chrnas/KartRobot/TSEA29 - Projektdokument/Användarhandledning/Figurer/20231201_112949.jpg

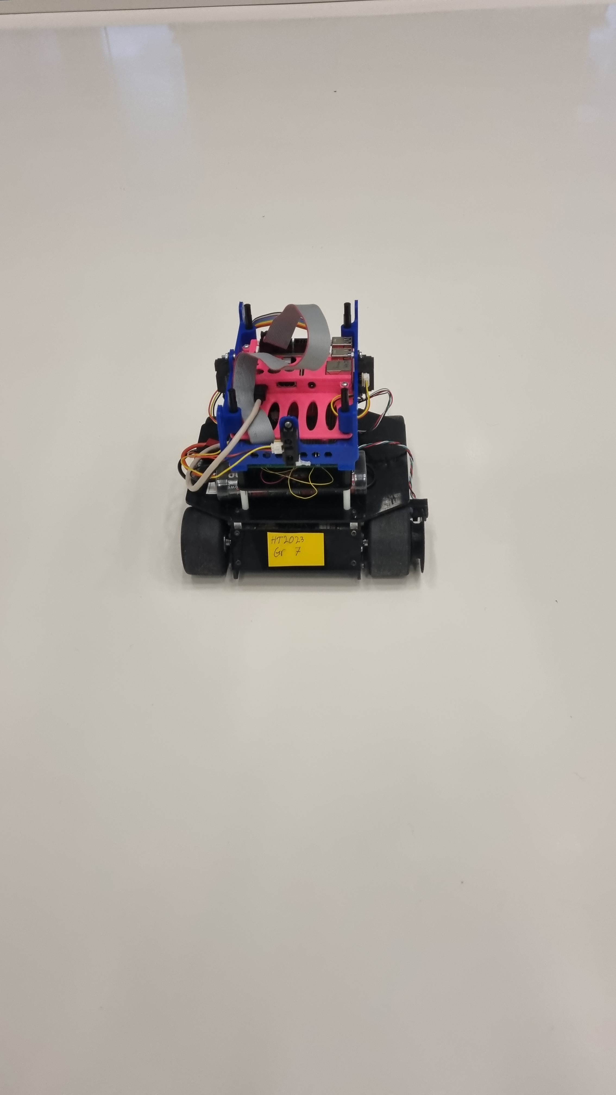
TSEA29 - Projektdokument/Användarhandledning/Figurer/20231201_112949.jpg
