chrnas/KartRobot/README.md

# TSEA29 KMM Kod

Detta är ett repo för kod i kursen TSEA29 (KMM).

## Medlemmar

* Felix Ramnelöv ([felra653@student.liu.se](mailto:felra653@student.liu.se))
* Filip Nygren  ([filny841@student.liu.se](mailto:filny841@student.liu.se))
* Jacob Volz  ([jacvo343@student.liu.se](mailto:jacvo343@student.liu.se))
* Hannes Lindström  ([hanli001@student.liu.se](mailto:hanli001@student.liu.se))
* Christoffer Näs  ([chrna581@student.liu.se](mailto:chrna581@student.liu.se))
* Mikael Lundgren  ([miklu523@student.liu.se](mailto:miklu523@student.liu.se))

## Handledare

* Theodor Lindberg  ([theodor.lindberg@liu.se](mailto:theodor.lindberg@liu.se))

## Workflow

Vi använder oss av ett feature branch workflow, där man gör en ny branch för varje feature enligt namnkonventionen `feature-*namn*` och gör sedan en merge till master. Rimligtvis är en aktivitet från tidplanen en feature.

## Kod

Stil för kod följer standard enligt språk man använder sig av. Kod ska vara välkommenterad och väldokumenterad.

## Produkt
