chrnas/KartRobot/TSEA29 - Projektdokument/Presentation/Presentation.pptx

## Kartrobot

TSEA29 - G07

Notes: Felix

## Agenda

- Översiktlig beskrivning
- Redovisning av det tekniska resultatet
- Hur vi arbetar och löst praktiska problem
- Varför oss?
- Frågor

Notes: Felix

## Översiktlig besrkivning

## Översikt

- Autonom robot som kartlägger en bana
  - Styralgoritm
- Moduluppbyggd
  - Specificerat gränssnitt
- Självständig
  - Kartläggning görs i roboten
- Användargränssnitt för uppritning & hantering
  - Trådlös kommunikation

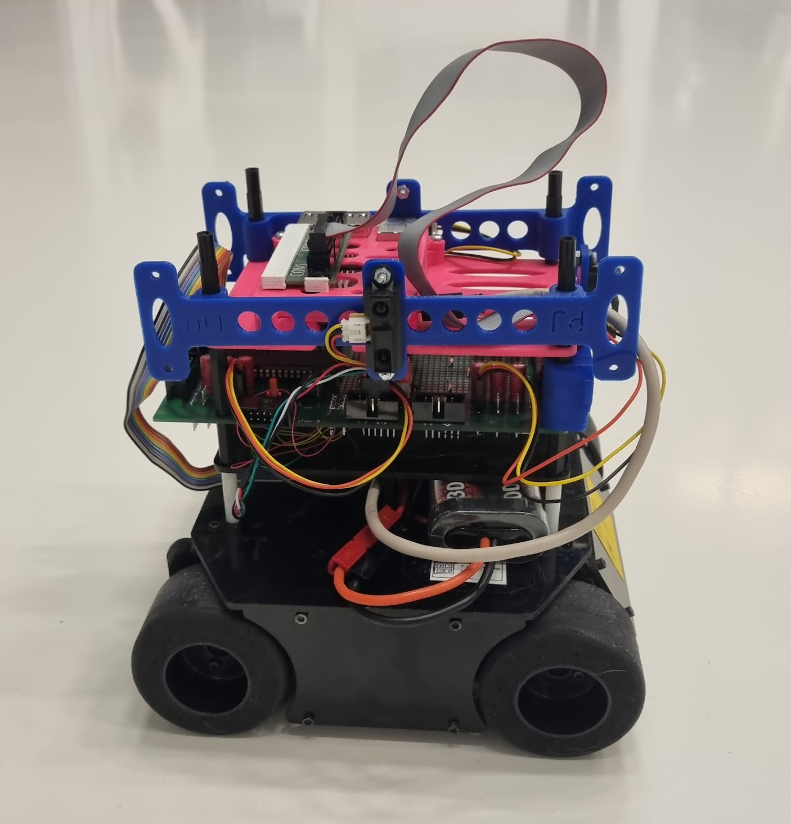
[picture p16: figure]

Notes: Jacob

## Redovisning av det tekniska resultatet

## Gränssnitt

- Inter-Integrated Circuit (I²C)
  - 1 buss
  - RPi master, 2 st AVR slavar
  - En byte skickas åt gången (Write & Read)
  - Python-bibliotek SMbus
- Bluetooth
  - Mellan RPi och extern dator
  - BT inbyggt på RPi
  - Python-bibliotek Socket

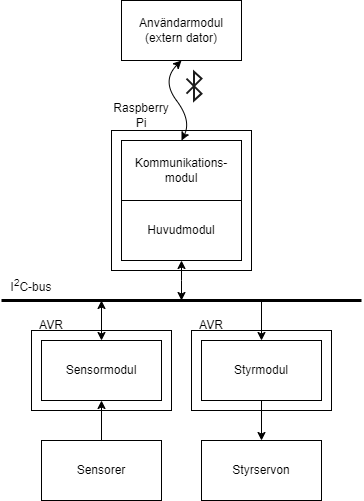
[picture p17: figure]

Notes: Hannes

## Sensormodul

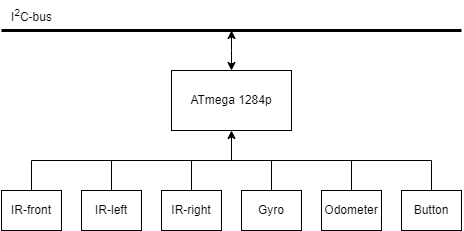
[picture p18: figure]

- Byggd på en AVR (ATmega 1284p)
- Flera sensorer
  - 3 st IR-avståndsmätare, 1 st odometer, 1 st gyroskop & 1 st dubbel tryckknapp
- Huvudloop med avbrott
- Analog & digital data
  - AD-omvandling
  - Avbrott
- TWI (I²C)
  - Slav (receiver & transmitter)
  - Write - välja data; Read - läsa vald data

Notes: Felix

## Styrmodul

- Kontrollerar robotens motorer
- Byggd på en AVR (Atmega1284p)
- 8-bitars insignalsvektor
- Huvudloop med avbrott
- TWI (I²C)
- 16-bitars Timer, Fast PWM (Pulse Width Modulation) Mode
  - PWM, Bra för strömreglering.

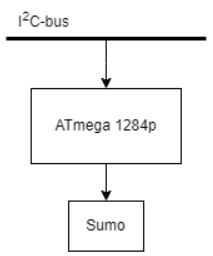
[picture p19: figure]
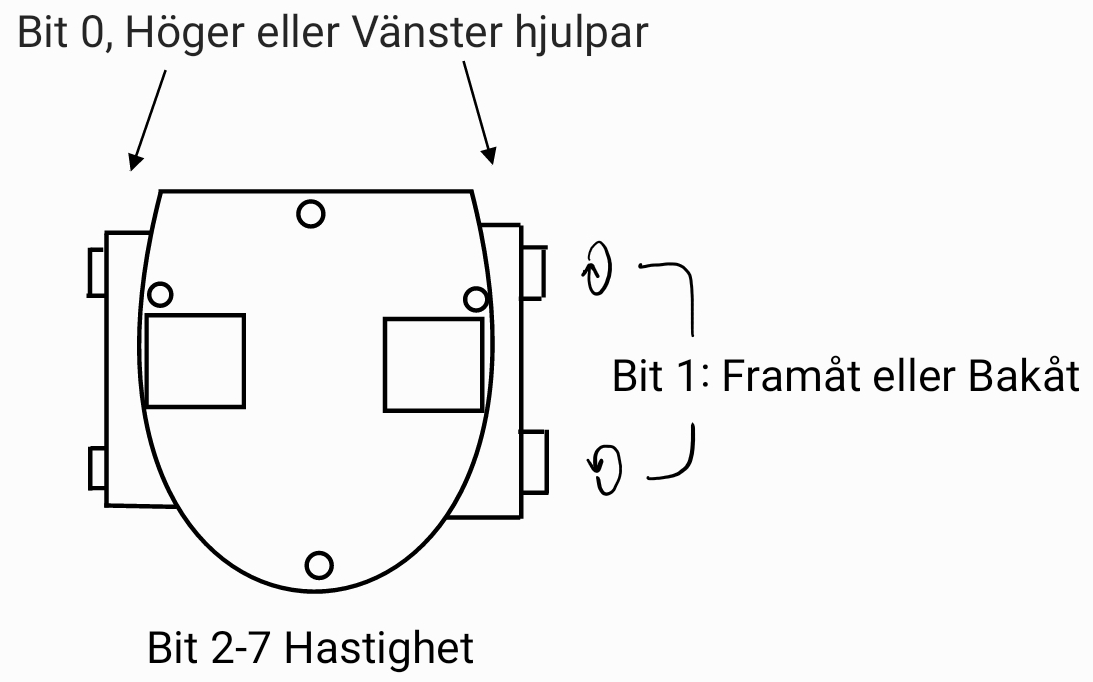
[picture p20: figure]

Kopplad till Sumo

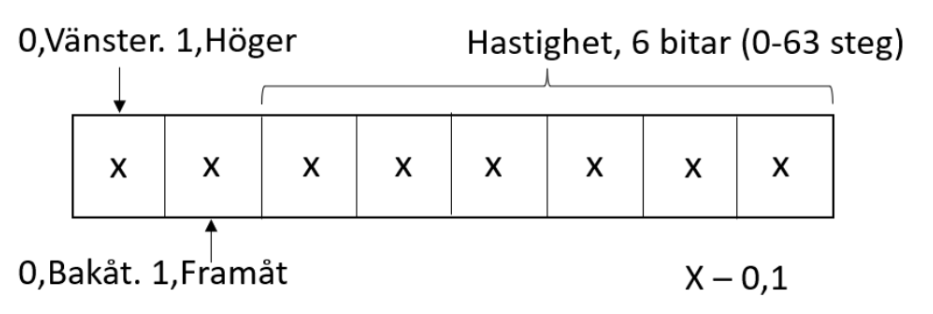
[picture p21: figure]

8-Bitars insignals vektor

Notes: Christoffer

## Kommunikationsmdodul

- Byggd på RPi (Raspberry Pi 3 Model B)
- Kommunikation med Bluetooth
  - Använder Python-biblioteket socket
  - Servern för Bluetooth byggd på RPi
- Skickar data från sensormodul och sökalgoritmen

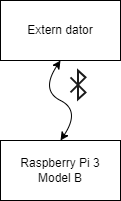
[picture p22: figure]

Notes: Jacob

## Användarmodul

- Skrivet i Python
  - På extern dator
  - PySide6
  - Python bibliotek för QT omgjort Från C++
  - Liten mängd QSS
- Funktioner
  - Uppritning av karta
  - Terminal för inkommande data
  - Knappar
  - Inforutor
  - Manuell styrning

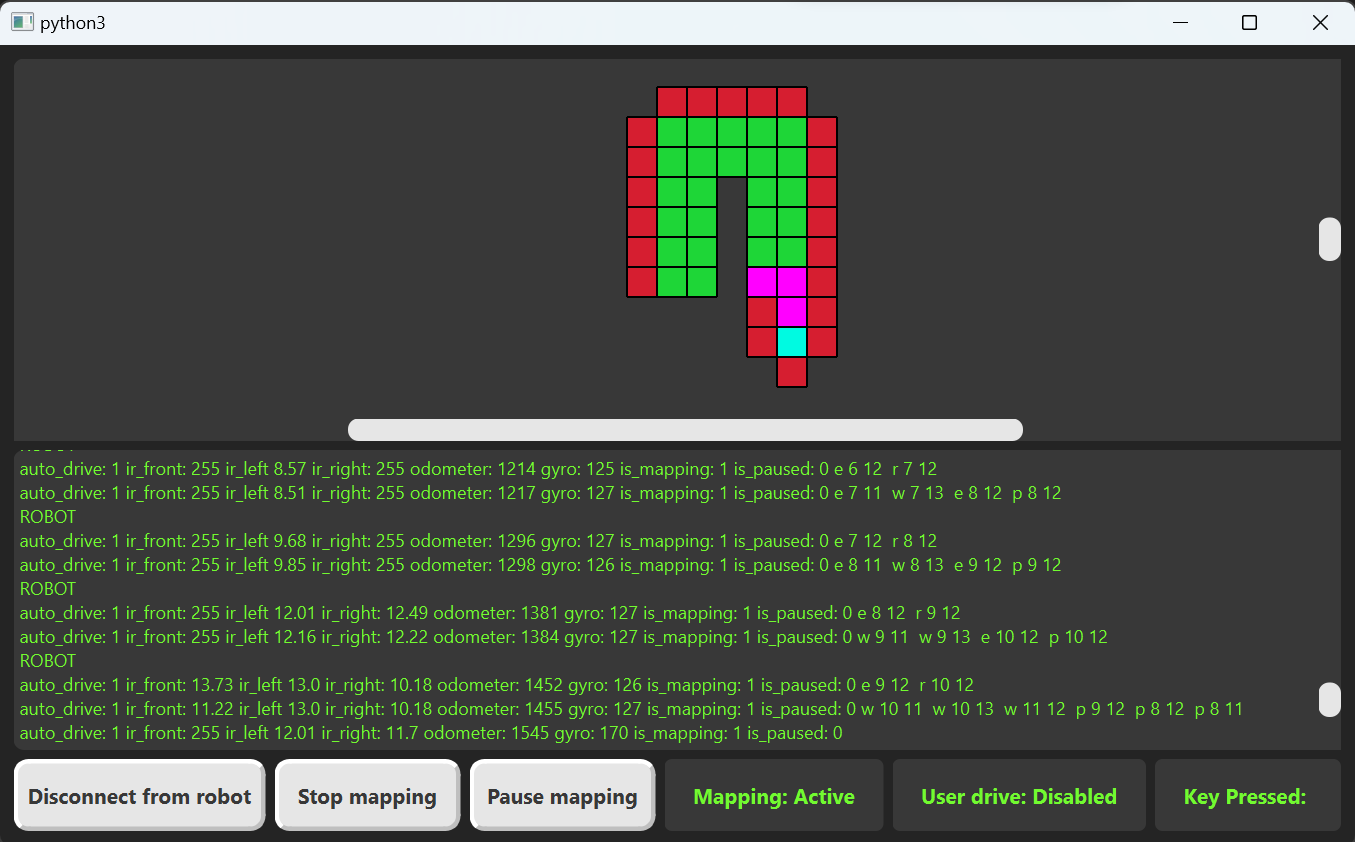
[picture p23: figure]

Notes: Hannes

## Huvudmodul

- Byggd på samma RPi som kommunikationsmodul
- “Spindeln i nätet”
  - Master på I²C-bussen
  - Ber om data från sensormodul
  - Kör SLAM-algoritm i Python
  - Skriver styrkommandon till styrmodul
  - Färdigställer och tillhandahåller data till kommunikationsmodul
  - Väljer autonomt/manuellt körläge
  - Väljer om bluetooth extern dator ska användas

Notes: Filip

## Hur vi arbetat och löst praktiska problem

## Arbetsätt

- V-model
- XP-principer
  - Parprogrammering
  - Testdriven utveckling (TDD)
- Modul-branches
  - En bransch per modul för parallellt arbete.

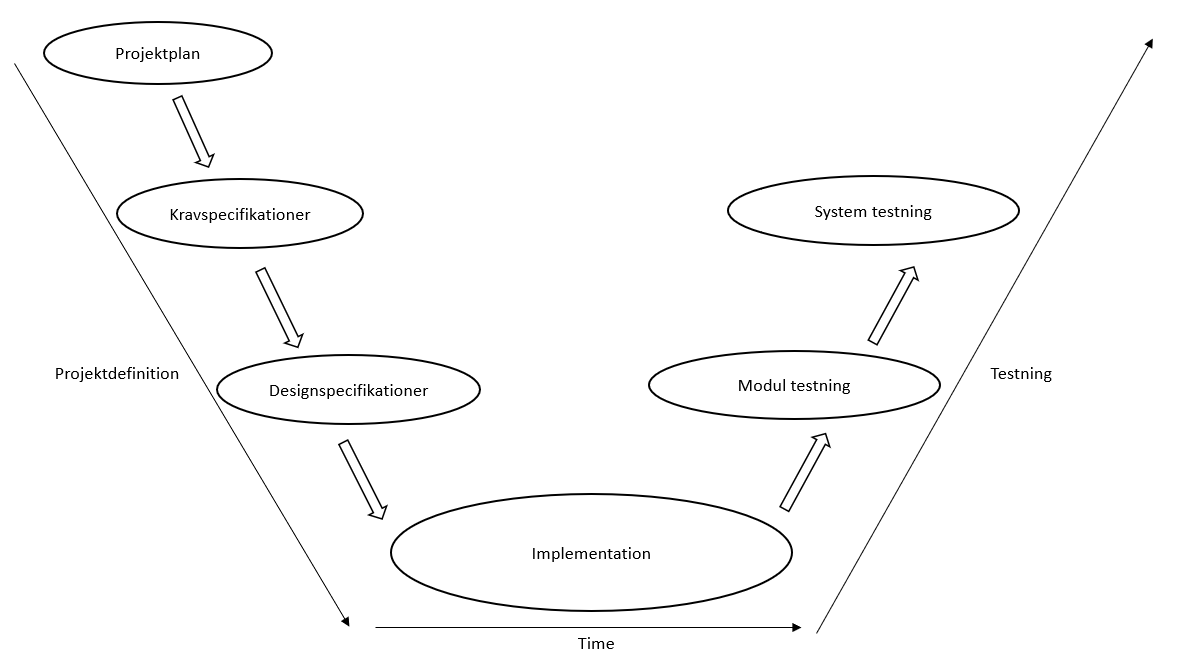
[picture p24: figure]

Projekt utformat efter V-model

Notes: Christoffer

## Praktiska problem

## Sökning

- Kartan
  - 2-dimensional array
  - 4 st sorters rutor
  - Okända, besökta, obesökta och väggar
- “Left-first” - DFS
  - Prioriterar obesökta rutor till vänster om roboten
  - Lägger på rutor till höger om och framför roboten först på avsöknings-stacken
- Smart avsökning
  - Säkerställer att en ruta borde besökas
  - Rutor som är omringade av kända rutor kastas ur avsöknings-stacken

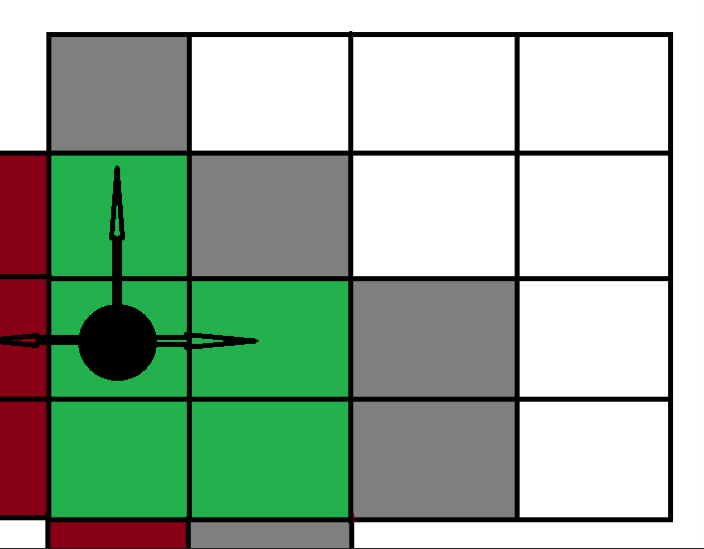
[picture p25: figure]

Notes: Mikael

## Pathfinding

- Hitta bästa väg till känd ruta
- Breadth first search (BFS)
  - Likt DFS med kö istället för stack
  - Roboten behöver inte röra sig när algoritmen utförs
  - Enkelt att implementera
- A* search algorithm
  - Manhattan Distance
  - Väg med färre svängar mer effektiv & mindre felmarginal
  - Prioritetskö med heuristik för väg med minst antal svängar
- Genomför båda och jämför
  - A* använder en heuristik vilket kan leda till fel i vissa fall

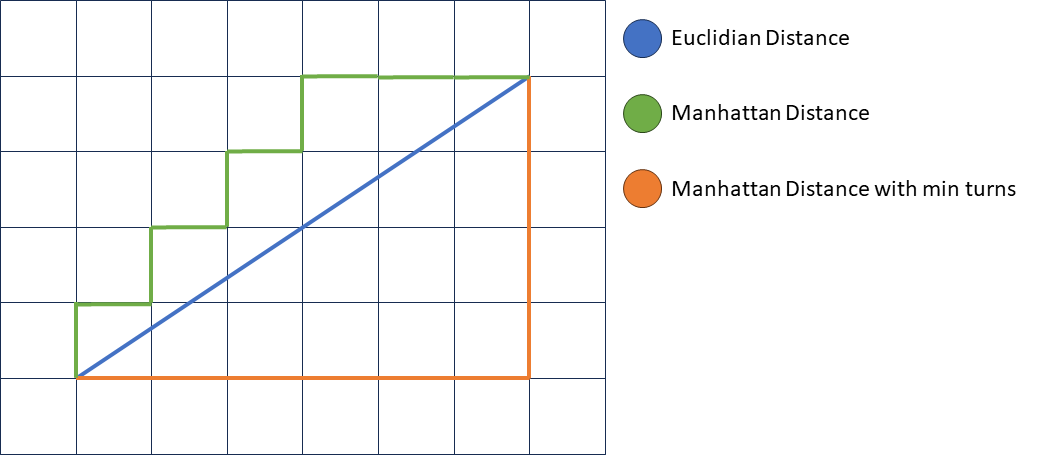
[picture p26: figure]

Notes: Felix

## Reglering

- Vid färd framåt
  - Reglering med avstånd från sidovägg
  - Kräver endast en IR-avståndssensor per sida
  - PD-reglering
    - Proportionell förändring (P)
    - Derivatan (D)
  - Använder gyro då ingen vägg synlig
  - Ökar och minskar hastighet samtidigt
- Vid rotering
  - Riktvärde på sammanlagd rotation
- Återställning innan sväng
  - Om möjligt, ställ in korrekt avstånd innan rotation

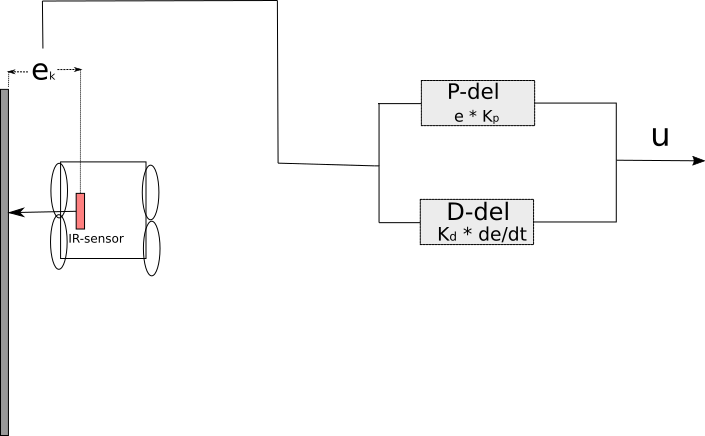
[picture p27: figure]

Notes: Filip

## Hur svänger roboten?

- Gyrons inverkan
  - Räkna ut vinkeln med hjälp av Riemannsummor
- Svängproblemet
  - Slirar
  - Svaga motorer
- Minimera svängproblemet
  - Full gas + sakta ned innan stop
  - Motverkar att motorerna ej klarar av att svänga
  - Slira så lite som möjligt

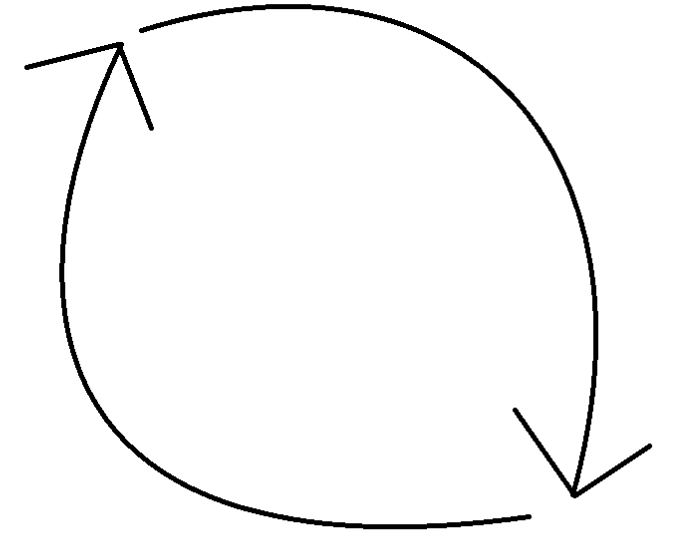
[picture p28: figure]

Notes: Mikael

## Varför oss?

## Varför oss?

- Vi är effektiva
- Levererar i god tid
- Nöjer oss inte med lagom
- Har god kommunikation m. beställare & handledare
- Har god samarbetsförmåga i gruppen
- Levererar bra och tydlig dokumentation

Notes: Felix

## Frågor?

## Tack för oss!
