chrnas/KartRobot/TSEA29 - Projektdokument/Beställarmöten/Beställarmöte 2023-09-05.docx

# Beställarmöte 2023-09-05

## Anteckningar

- “Enkelt att byta ut en modul” eller “slingra sig fram” kan skrivas “enligt beställarens uppfattning” för att göra det enkelt.
- Laptopen kan ses som en extern modul, kanske ska skrivas som separat i kravspec.
- Kalibrering och display på roboten kan skrivas som krav av typen extra (Prioritet 2).
- Manuellt läge behöver inte kartlägga som krav.
- Brytare på roboten, ska kunna köra utan separat laptop.
- Hastigheten på roboten styrs genom att om signalen som skickas till hjulen är hög 10% av tiden och låg 90% av tiden kommer hastigheten vara 10% av maxhastigheten.
- Rasberry-Pi har redan inbyggd hårdvara för Bluetooth och Wi-Fi, dsv. bra för kommunikationsmodulen.
- Kör “Ctrl + F” och sök efter “ska” i projektdirektivet för att hitta krav.
- Bilda banspec-grupp, inte bråttom.
- Ha så få och så generella krav som möjligt.
