chrnas/KartRobot/TSEA29 - Projektdokument/Statusrapport/Statusrapport tidplan.xlsx

Felix |  |  |  | Mikael
Vecka | 49 | 50 | 51 | Vecka | 49 | 50 | 51
Timmar | 18 | 18 | 12 | Timmar | 27 | 27 | 12
Aktivitet | Projektrapport, tidrapport, tekdok, anv-handl., eftersökning, testning av huvudmodul, systemtesning | Projektrapport, tidrapport, tekdok, anv-handl., presentation, eftersökning, testning av huvudmodul, systemtestning | Projektrapport, tidrapport, presentation, eftersökning, buffert | Aktivitet | Systemtest, reglering, sökalgoritm, integrering med övriga moduler, teknisk dokumentation | Systemtest, integrering med övriga moduler, eftersökning, teknisk dokumentation, Användarhandledning, Presentation | Systemetes, presentation
Filip |  |  |  | Hannes
Vecka | 49 | 50 | 51 | Vecka | 49 | 50 | 51
Timmar | 23 | 21 | 12 | Timmar | 23 | 23 | 17
Aktivitet | Systemtest, eftersökning, reglering, projektrapport, Presentation | Systemtest, eftersökning, reglering, projektrapport, tek-dok, anv. handledning, presentation | Presentation, systemtest | Aktivitet | Systemtest, tek-dok, presentation anv handledning eftersökning | Systemtest, tek-dok, presentation anv handledning eftersökning | Tek-dok presentation eftersökning
Jacob |  |  |  | Christoffer
Vecka | 49 | 50 | 51 | Vecka | 49 | 50 | 51
Timmar | 26 | 24 | 12 | Timmar | 25 | 25 | 10
Aktivitet | systemtest, eftersökning extern dator, teknisk dokumentation, | systemtest, eftersökning extern dator, teknisk dokumentation, presenation | projektrapport, presentation | Aktivitet | Systemtest,Datorkommunikation, datorstyrning,kartläggning, testning av extern dator,teknisk dokumentation,presentation. | Systemtest,Datorkommunikation, datorstyrning,kartläggning, testning av extern dator,presentation,projektrapport,användarhandledning. | Systemtest,Datorkommunikation, datorstyrning,kartläggning, testning av extern dator,projekt rapport
