chrnas/KartRobot/TSEA29 - Projektdokument/Användarhandledning/Figurer/20231201_112933.jpg

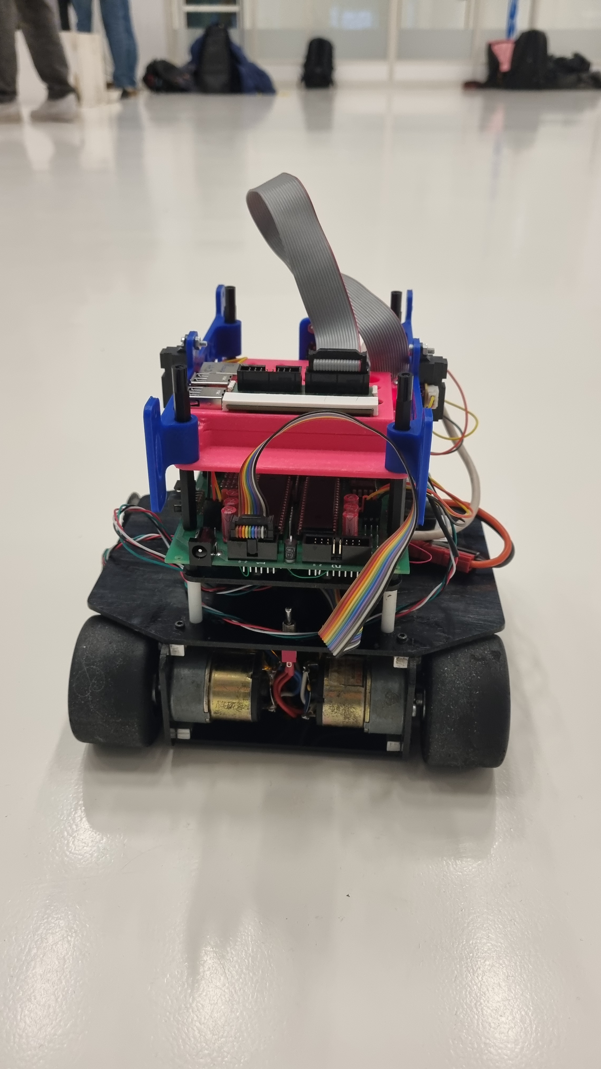
TSEA29 - Projektdokument/Användarhandledning/Figurer/20231201_112933.jpg
