chrnas/KartRobot/TSEA29 - Projektdokument/Användarhandledning/Figurer/Screenshot 2023-12-01 113502.png

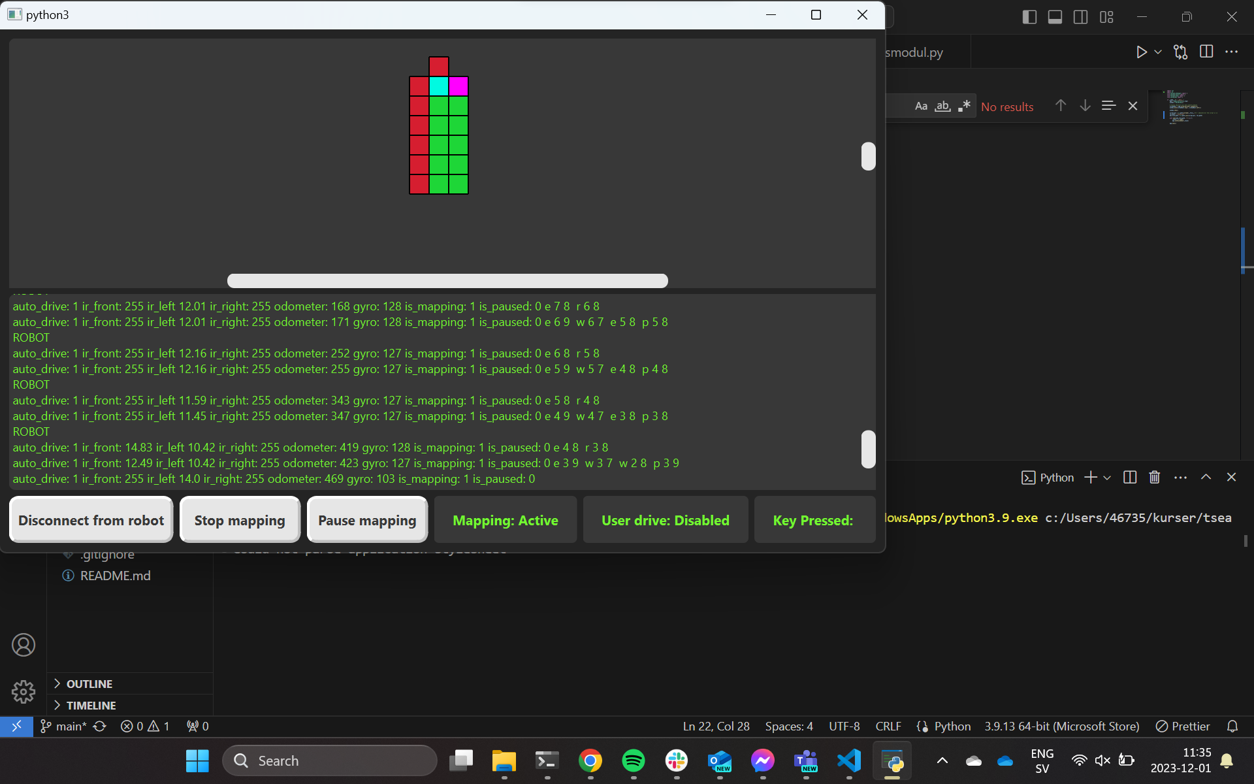
TSEA29 - Projektdokument/Användarhandledning/Figurer/Screenshot 2023-12-01 113502.png
