chrnas/KartRobot/TSEA29 - Projektdokument/Användarhandledning/Figurer/Screenshot 2023-12-01 114236.png

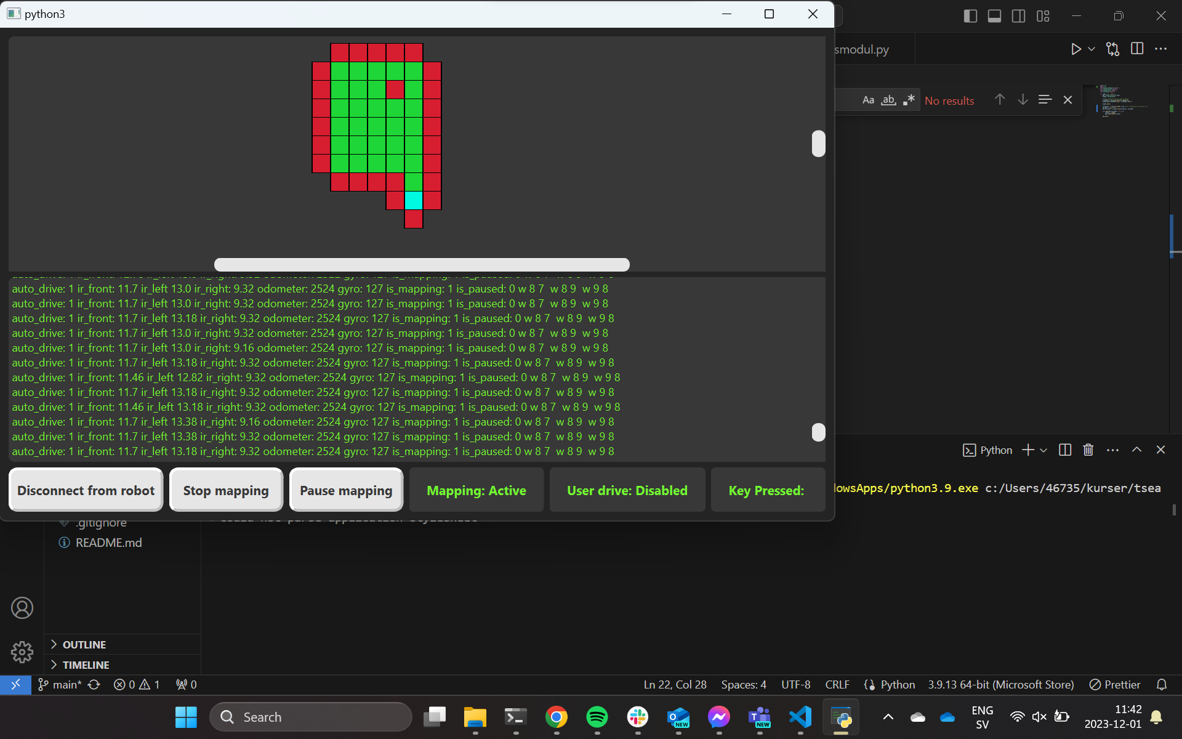
TSEA29 - Projektdokument/Användarhandledning/Figurer/Screenshot 2023-12-01 114236.png
